yasinsaad/EEE4518-Team_Injinn/(commit log)

2026-10-31 Document demonstration video and add demo frames
    Claude-Session: https://claude.ai/code/session_01WcwuPY1MVDMvQ9B2kKtKxD
2026-10-31 Add PC demo build and development prototypes; document code history
    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
2026-10-31 Reorganize repo by component, clean up and document code
    - Move code into raspberry-pi/, arduino/injinn_firmware/, portal/
    - main.py: constants, docstrings, --preview/--port, runs without Arduino,
    resume cloud score, open serial before threads
    - Firmware: non-blocking beep, debounced SOS, remove dead code
    - Portal: header comment, remove leftover analytics tag
    - Move PC demo into prototypes/, add header docstrings
    - Add .gitignore; rewrite README
    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
